gpitel/Lab/hardware/relay-board-revC/relay_board_BOM.md

# OpenMagnetics Relay Board rev C -- Bill of Materials
# GENERATED by generate_bom.py from relay_board.xml -- do not edit.

| Refs | Qty | Value | Part number | Notes |
|---|-----|---|---|---|
| C1,C23,C32,C33,C34,C35 | 6 | 10uF | - | C_0805_2012Metric |
| C18 | 1 | 1uF | - | C_0402_1005Metric |
| C19 | 1 | 10nF | - | C_0402_1005Metric |
| C2,C29 | 2 | 4.7uF | - | C_0805_2012Metric |
| C22 | 1 | 47uF | X5R 10 V 1206 | front-end output DC block |
| C3,C4,C20,C21 | 4 | 1uF | - | C_0603_1608Metric |
| C30 | 1 | 10pF C0G | - | C_0603_1608Metric |
| C31 | 1 | 4.7nF 100V | - | C_0603_1608Metric |
| C5-C37 | 17 | 100nF | - | C_0402_1005Metric |
| D1 | 1 | RUN | 0603 LED green | status: firmware running / USB host |
| D2 | 1 | USBLC6-2SC6 | ST USBLC6-2SC6 | USB 2.0 ESD array, IEC 61000-4-2 level 4 |
| D3,D4 | 2 | BAV99 | Nexperia BAV99,215 | front-end input clamp |
| D5 | 1 | PWR | 0603 LED green | status: power |
| D6 | 1 | BUSY | 0603 LED amber | status: relays switching |
| D7 | 1 | KELVIN | 0603 LED blue | status: Kelvin mode |
| D8 | 1 | PROG | 0603 LED red (KT-0603R) | status: DFU / firmware update |
| D9 | 1 | SMF5.0A | - | D_SOD-123F |
| FB1 | 1 | 220R@100MHz 2A | Murata BLM21PG221SN1D | VBUS ferrite, 2 A |
| FB2,FB3 | 2 | 600R@100MHz | Sunlord GZ1608D601TF | ferrite, 200 mA (VDDA, +5VA) |
| J1 | 1 | USB-C | HRO TYPE-C-31-M-12 | USB-C receptacle, USB 2.0, 16 pin |
| J10 | 1 | DUT A F | Grayhill 02-21 miniature test clip (banana plug) | Kelvin pair per terminal (F/S, 8 mm apart); plug straight into the plated 4.0 mm hole, hand-fitted (solder for a permanent fixture) |
| J11 | 1 | DUT A S | Grayhill 02-21 miniature test clip (banana plug) | Kelvin pair per terminal (F/S, 8 mm apart); plug straight into the plated 4.0 mm hole, hand-fitted (solder for a permanent fixture) |
| J12 | 1 | DUT B F | Grayhill 02-21 miniature test clip (banana plug) | Kelvin pair per terminal (F/S, 8 mm apart); plug straight into the plated 4.0 mm hole, hand-fitted (solder for a permanent fixture) |
| J13 | 1 | DUT B S | Grayhill 02-21 miniature test clip (banana plug) | Kelvin pair per terminal (F/S, 8 mm apart); plug straight into the plated 4.0 mm hole, hand-fitted (solder for a permanent fixture) |
| J14 | 1 | DUT C F | Grayhill 02-21 miniature test clip (banana plug) | Kelvin pair per terminal (F/S, 8 mm apart); plug straight into the plated 4.0 mm hole, hand-fitted (solder for a permanent fixture) |
| J15 | 1 | DUT C S | Grayhill 02-21 miniature test clip (banana plug) | Kelvin pair per terminal (F/S, 8 mm apart); plug straight into the plated 4.0 mm hole, hand-fitted (solder for a permanent fixture) |
| J16 | 1 | DUT D F | Grayhill 02-21 miniature test clip (banana plug) | Kelvin pair per terminal (F/S, 8 mm apart); plug straight into the plated 4.0 mm hole, hand-fitted (solder for a permanent fixture) |
| J17 | 1 | DUT D S | Grayhill 02-21 miniature test clip (banana plug) | Kelvin pair per terminal (F/S, 8 mm apart); plug straight into the plated 4.0 mm hole, hand-fitted (solder for a permanent fixture) |
| J6 | 1 | BNC SOURCE | Amphenol B6252HB-NPP3G-50 | 50R right-angle BNC jack |
| J7 | 1 | BNC CH1 | Amphenol B6252HB-NPP3G-50 | 50R right-angle BNC jack |
| J8 | 1 | SWD | CNC Tech 3220-10-0300-00 | 1.27 mm 2x5 Cortex debug header, SMD |
| J9 | 1 | BNC CH2 | Amphenol B6252HB-NPP3G-50 | 50R right-angle BNC jack |
| K1-K23 | 23 | G6K-2F-RF-S DC5 | Omron G6K-2F-RF-S DC5 | high-frequency DPDT relay, 5 V coil |
| L1 | 1 | 90R CM | TDK ACM2012-900-2P-T002 | USB CM choke, 90R @100 MHz; windings 1-4 / 2-3 |
| R1,R2 | 2 | 5.1k | - | R_0402_1005Metric |
| R10,R32,R33,R35,R38,R39 | 6 | 4.7k | - | R_0402_1005Metric |
| R12 | 1 | 1k 0.1% | Vishay TNPW08051K00BEEA | bridge RV1: 1k 0.1% 25 ppm thin film |
| R13,R16 | 2 | 47R 0.1% | Vishay TNPW080547R0BEEA | bridge RV2/RC2: 47R 0.1% 25 ppm thin film |
| R14,R15 | 2 | 4R7 | UNI-ROYAL TC0525B470KT5G (LCSC C21571495) | bridge RC1 shunt half: 4R7 0.1% 25 ppm thin film, JLC stock (two in parallel = 2R35); equivalent: Vishay TNPW08054R70BEEA |
| R17,R34 | 2 | 1k | - | R_0402_1005Metric |
| R18 | 1 | 1R 0.5% | - | R_1206_3216Metric |
| R20,R22,R29,R40 | 4 | 100k | - | R_0402_1005Metric |
| R21,R23 | 2 | 100R | - | R_0402_1005Metric |
| R24,R25,R26,R27 | 4 | 1k 0.1% | Yageo RT0603BRD071KL | front-end difference stage, 0.1 % 25 ppm |
| R28 | 1 | 49.9R | - | R_0402_1005Metric |
| R3,R4,R31,R41 | 4 | 10k | - | R_0402_1005Metric |
| R30 | 1 | 18k | - | R_0402_1005Metric |
| R36 | 1 | 1M | - | R_0603_1608Metric |
| R37 | 1 | 0R | - | R_0603_1608Metric |
| R5 | 1 | 100R 0.1% | Vishay TNPW0805100RBEEA | LOAD standard: 100R 0.1% 25 ppm thin film |
| SW1 | 1 | BOOT | C&K TL3342F160QG (or XKB TS-1187A-B-A-B) | SMD tact switch: hold at power-up for ROM DFU |
| SW2 | 1 | RESET | C&K TL3342F160QG (or XKB TS-1187A-B-A-B) | SMD tact switch: NRST |
| U1 | 1 | STM32F072CBT6 | ST STM32F072CBT6 | Cortex-M0, 128K flash, crystal-less USB (HSI48 + CRS) |
| U11 | 1 | TPS2051CDBV | - | SOT-23-5 |
| U12 | 1 | TMP117AIDRV | - | WSON-6-1EP_2x2mm_P0.65mm_EP1x1.6mm |
| U2,U3,U4,U6 | 4 | TBD62003APG | Toshiba TBD62003AFG | 7ch DMOS sink driver (SOIC-16 = AFG suffix) |
| U5 | 1 | AP2112K-3.3 | Diodes AP2112K-3.3TRG1 | 3.3 V 600 mA LDO, 250 mV dropout |
| U7,U8,U9,U10 | 4 | OPA356 | TI OPA356AIDBVR | 200 MHz RRO op-amp, single 2.5-5.5 V (Kelvin front-end) |

Total placements: 132

Hardware (not in the netlist):

| Item | Qty | Part | Notes |
|---|-----|---|---|
| Standoff M3 x 25 mm, F-F | 5 | Wurth 970250321 (WA-SSTII, steel; or any M3 hex standoff >= 25 mm) | legs under H1-H5: the 02-21 banana plugs stand ~22 mm below the board |
| Screw M3 x 6 mm | 5 | any | board to standoffs |

Notes:
- All components on the top side; single-sided assembly.
- R5 is the calibration LOAD standard: substitutions must hold 0.1%
  and low TCR or every calibrated measurement inherits the error.
- Relays: G6K-2F-RF-S DC5 (5 V coil suits the USB-derived +5 V rail
  through the TBD62003's ~0.15 V drop). ~26 week lead time -- order first.
- USB VID/PID are pid.codes test values; register before distributing.
