gpitel/Lab/hardware/relay-board-revC/relay_board_JLC_BOM.xlsx

Comment | Designator | Footprint | JLCPCB Part #（optional）
CL21A106KAYNNNE | C1,C23,C32,C33,C34,C35 | C0805 | C15850
CL05A105KA5NQNC | C18 | C0402 | C52923
CL05B103KB5NNNC | C19 | C0402 | C15195
CL21A475KAQNNNE | C2,C29 | C0805 | C1779
CL31A476MPHNNNE | C22 | C1206 | C96123
CL10A105KB8NNNC | C3,C4,C20,C21 | C0603 | C15849
GRM1885C1H100GA01D | C30 | C0603 | C2987939
CL05B104KO5NNNC | C5,C6,C7,C8,C9,C10,C11,C12,C15,C16,C17,C25,C26,C27,C28,C36,C37 | C0402 | C1525
XL-1608SYGC-06 | D1 | LED0603 | C965805
USBLC6-2SC6 | D2 | SOT-23-6 | C2827654
BAV99,215 | D3,D4 | SOT-23 | C2500
XL-1608SYGC-06 | D5 | LED0603 | C965805
XL-1608UYC-06 | D6 | LED0603 | C965802
XL-1608UBC-04 | D7 | LED0603 | C965807
KT-0603R | D8 | LED0603 | C2286
SMF5.0A | D9 | D_SOD-123F | C151296
BLM21PG221SN1D | FB1 | L0805 | C85840
GZ1608D601TF | FB2,FB3 | L0603 | C1002
TYPE-C-31-M-12 | J1 | USB_C_Receptacle_HRO_TYPE-C-31-M-12 | C165948
HX PZ1.27-2x5P TP | J8 | PinHeader_2x05_P1.27mm_Vertical_SMD | C41376037
G6K-2F-Y-TR DC5 | K1,K2,K3,K4,K5,K6,K7,K8,K9,K10,K11,K12,K13,K14,K15,K16,K17,K18,K19,K20,K21,K22,K23 | Relay_Omron_G6K-2F-RF-S | C47190
ACM2012-900-2P-T001 | L1 | L_CommonModeChoke_Coilank_ACM2012 | C307642
0402WGF5101TCE | R1,R2 | R0402 | C25905
0402WGF4701TCE | R10,R32,R33,R35,R38,R39 | R0402 | C25900
TNPW08051K00BEEA | R12 | R0805 | C2073519
RT0805BRD0747RL | R13,R16 | R0805 | C136921
TC0525B470KT5G | R14,R15 | R0805 | C21571495
0402WGF1001TCE | R17,R34 | R0402 | C11702
RT1206DRD071RL | R18 | R1206 | C111291
0402WGF1003TCE | R20,R22,R29,R40 | R0402 | C25741
0402WGF1000TCE | R21,R23 | R0402 | C25076
RT0603BRD071KL | R24,R25,R26,R27 | R0603 | C110776
0402WGF499JTCE | R28 | R0402 | C25120
0402WGF1002TCE | R3,R4,R31,R41 | R0402 | C25744
0402WGF1802TCE | R30 | R0402 | C25762
0603WAF0000T5E | R37 | R0603 | C21189
TNPW0805100RBEEA | R5 | R0805 | C2073390
TS-1187A-B-A-B | SW1 | SW_SPST_TL3342 | C318884
TS-1187A-B-A-B | SW2 | SW_SPST_TL3342 | C318884
STM32F072CBT6 | U1 | LQFP-48 | C81720
TPS2051CDBVR | U11 | SOT-23-5 | C129581
TMP117AIDRVR | U12 | WSON-6-1EP_2x2mm_P0.65mm_EP1x1.6mm | C699536
TBD62003AFG(Z,EL) | U2,U3,U4,U6 | SOIC-16 | C163227
AP2112K-3.3TRG1 | U5 | SOT-23-5 | C23380830
OPA356AIDBVR | U7,U8,U9,U10 | SOT-23-5 | C183100
