gpitel/Lab/(list of files, drawings)

Other design files:
hardware/relay-board-revC/relay_board.dsn
