gpitel/Lab/hardware/relay-board-revC/relay_board.kicad_pcb

## KiCad design hardware/relay-board-revC/relay_board.kicad_pcb (2026-10-26)

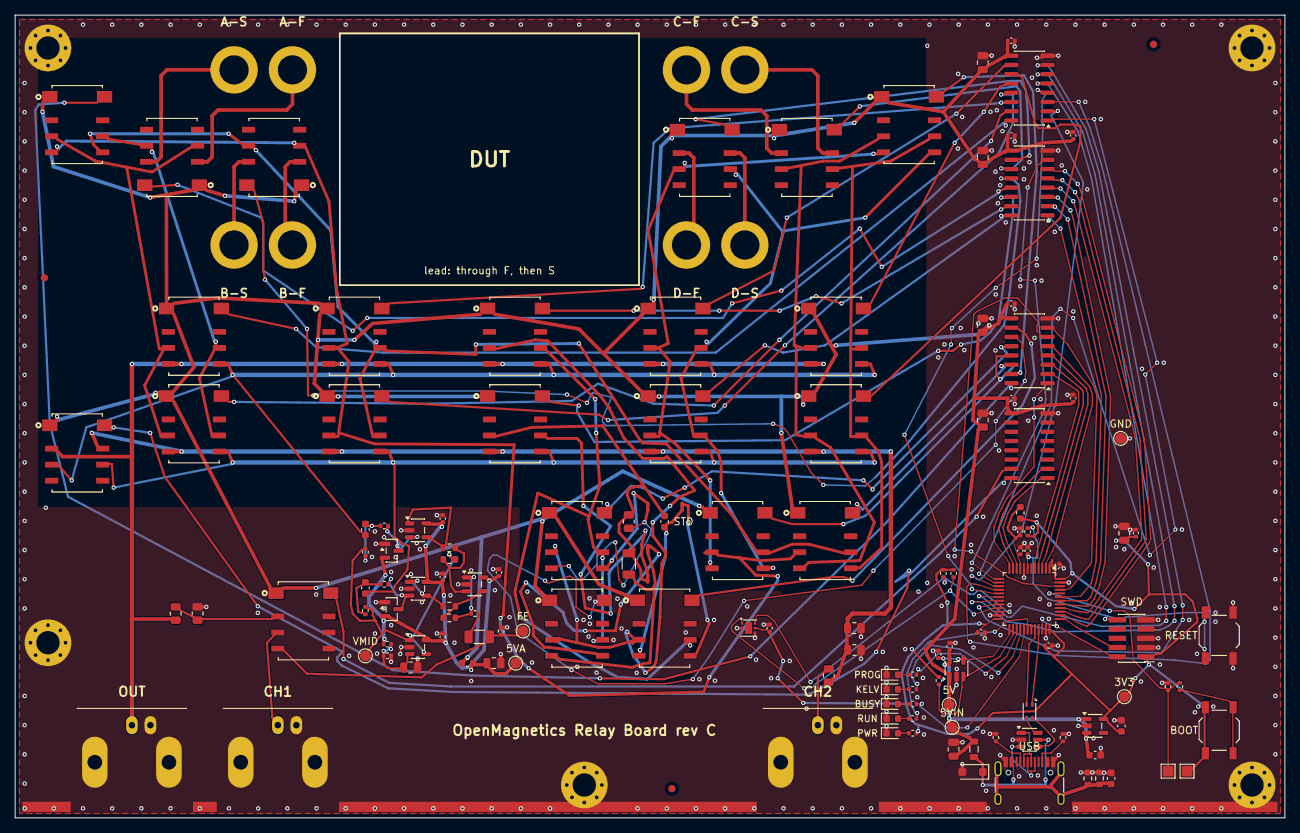
[picture p1: board relay_board.kicad_pcb from above]

Board: 4 copper layers, 174.0 x 110.0 mm, 158 parts (0 on the bottom side), 126 nets.

Parts:
BOND1, BOND2, BOND3, BOND4, BOND5: GND bonding strip; GND_BondingStrip
C1, C2, C23, C29, C32, C33, C34, C35: C_0805_2012Metric
C3, C4, C20, C21, C30, C31: C_0603_1608Metric
C5, C6, C7, C8, C9, C10, C11, C12, C15, C16, C17, C18, C19, C25, C26, C27, C28, C36, C37: C_0402_1005Metric
C22: C_1206_3216Metric
D1, D5, D6, D7, D8: LED_0603_1608Metric
D2: SOT-23-6
D3, D4: SOT-23
D9: D_SOD-123F
FB1: L_0805_2012Metric
FB2, FB3: L_0603_1608Metric
FID1, FID2, FID3: Fiducial_1mm_Mask2mm
H1, H2, H3, H4, H5: MountingHole_3.2mm_M3_Pad_Via
J1: USB_C_Receptacle_HRO_TYPE-C-31-M-12
J6, J7, J9: BNC_Amphenol_B6252HB-NPP3G-50_Horizontal
J8: PinHeader_2x05_P1.27mm_Vertical_SMD
J10, J11, J12, J13, J14, J15, J16, J17: Grayhill 02-21; Grayhill_02-21_BananaPlug_4mm
K1, K2, K3, K4, K5, K6, K7, K8, K9, K10, K11, K12, K13, K14, K15, K16, K17, K18, K19, K20, K21, K22, K23: G6K-2F-RF-S; Relay_Omron_G6K-2F-RF-S
L1: L_CommonModeChoke_Coilank_ACM2012
NT1, NT2, NT4, NT5: NetTie-2_SMD_Pad0.5mm
R1, R2, R3, R4, R10, R17, R20, R21, R22, R23, R28, R29, R30, R31, R32, R33, R34, R35, R38, R39, R40, R41: R_0402_1005Metric
R5, R12, R13, R14, R15, R16: R_0805_2012Metric
R18: R_1206_3216Metric
R24, R25, R26, R27, R36, R37: R_0603_1608Metric
SW1, SW2: SW_SPST_TL3342
TP1, TP2: TestPoint_Pad_1.5x1.5mm
TP3, TP4, TP5, TP6, TP7, TP8, TP9: TestPoint_Pad_D1.5mm
U1: LQFP-48_7x7mm_P0.5mm
U2, U3, U4, U6: SOIC-16_3.9x9.9mm_P1.27mm
U5, U7, U8, U9, U10, U11: SOT-23-5
U12: WSON-6-1EP_2x2mm_P0.65mm_EP1x1.6mm

Connections:
/+3V3: C2.1, C4.1, C8.1, C9.1, C16.1, C17.1, C36.1, FB3.1, J8.1, R3.1, R32.1, R38.2, R39.2, R41.2, SW1.1, TP2.1, TP5.1, U1.1, U1.24, U1.36, U1.48, U5.5, U12.5
/+3V3A: C18.1, C19.1, FB3.2, U1.9
/+5V: C5.1, C6.1, C7.1, C10.1, C11.1, C12.1, C32.1, C33.1, C34.1, C35.1, FB2.1, K1.1, K2.1, K3.1, K4.1, K5.1, K6.1, K7.1, K8.1, K9.1, K10.1, K11.1, K12.1, K13.1, K14.1, K15.1, K16.1, K17.1, K18.1, K19.1, K20.1, K21.1, K22.1, K23.1, TP3.1, U2.9, U3.9, U4.9, U6.9, U11.1
/+5VA: C25.1, C26.1, C27.1, C28.1, C29.1, D3.2, D4.2, FB2.2, R30.1, TP6.1, U7.5, U8.5, U9.5, U10.5
/+5V_IN: C1.1, C3.1, C37.1, FB1.2, TP4.1, U5.1, U5.3, U11.5
/BOOT0: R4.1, R17.2, TP1.1, U1.44
/BOOT_SW: R17.1, SW1.2
/BUSY_A: D6.2, R33.2
/CAL_E: K9.3, K19.3, K20.3, K21.3
/CAL_ES: K9.6, K19.6, K20.6, K21.6
/CAL_F: C30.2, K10.3, NT2.1, R5.2, R18.2
/CAL_FS: K10.6, NT2.2
/CC1: J1.A5, R1.1
/CC2: J1.B5, R2.1
/CH1_BNC: J7.1, K23.3
/CH1_NODE: K23.2, R12.2, R13.1
/CH2_NODE: J9.1, R16.2
/COIL_EN: R40.1, U1.25, U11.4
/COIL_FLT: R41.1, U1.26, U11.3
/DUTS_A: J11.1, K11.7
/DUTS_B: J13.1, K12.7
/DUTS_C: J15.1, K13.7
/DUTS_D: J17.1, K14.7
/DUT_A: J10.1, K11.2
/DUT_B: J12.1, K12.2
/DUT_C: J14.1, K13.2
/DUT_D: J16.1, K14.2
/FE_AMP: R25.2, R28.1, U9.1
/FE_BN: R24.1, U8.1, U8.4
/FE_BP: R26.1, U7.1, U7.4
/FE_DM: R24.2, R25.1, U9.4
/FE_DP: R26.2, R27.1, U9.3
/FE_INN: C21.2, R22.1, R23.1
/FE_INP: C20.2, R20.1, R21.1
/FE_N: D4.3, R23.2, U8.3
/FE_OUT: C22.2, K23.4, R29.1, TP8.1
/FE_P: D3.3, R21.2, U7.3
/FE_R: C22.1, R28.2
/GND: BOND1.1, BOND2.1, BOND3.1, BOND4.1, BOND5.1, C1.2, C2.2, C3.2, C4.2, C5.2, C6.2, C7.2, C8.2, C9.2, C10.2, C11.2, C12.2, C15.2, C16.2, C17.2, C18.2, C19.2, C23.2, C25.2, C26.2, C27.2, C28.2, C29.2, C31.2, C32.2, C33.2, C34.2, C35.2, C36.2, C37.2, D1.1, D2.2, D3.1, D4.1, D5.1, D6.1, D7.1, D8.1, D9.2, H1.1, H2.1, H3.1, H4.1, H5.1, J1.A1, J1.A12, J1.B1, J1.B12, J6.2, J7.2, J8.3, J8.5, J8.9, J9.2, R1.2, R2.2, R4.2, R13.2, R14.2, R15.2, R29.2, R31.2, R36.2, R37.2, R40.2, SW2.2, TP9.1, U1.8, U1.23, U1.35, U1.47, U2.8, U3.8, U4.8, U5.2, U6.8, U7.2, U8.2, U9.2, U10.2, U11.2, U12.2, U12.4
/GPIO1: U1.14, U2.1
/GPIO2: U1.15, U2.2
/GPIO3: U1.16, U2.3
/GPIO4: U1.17, U2.4
/GPIO5: U1.18, U2.5
/GPIO6: U1.19, U2.6
/GPIO7: U1.20, U2.7
/GPIO8: U1.43, U3.1
/GPIO9: U1.42, U3.2
/GPIO10: U1.41, U3.3
/GPIO11: U1.40, U3.4
/GPIO12: U1.39, U3.5
/GPIO13: U1.38, U3.6
/GPIO14: U1.13, U3.7
/GPIO15: U1.12, U4.1
/GPIO16: U1.5, U4.2
/GPIO17: U1.4, U4.3
/GPIO18: U1.3, U4.4
/GPIO19: U1.2, U4.5
/GPIO20: U1.46, U4.6
/GPIO21: U1.45, U4.7
/GPIO22: U1.10, U6.1
/GPIO23: U1.11, U6.2
/I2C_SCL: R38.1, U1.21, U12.1
/I2C_SDA: R39.1, U1.22, U12.6
/K1_COIL: K1.8, U2.16
/K2_COIL: K2.8, U2.15
/K3_COIL: K3.8, U2.14
/K4_COIL: K4.8, U2.13
/K5_COIL: K5.8, U2.12
/K6_COIL: K6.8, U2.11
/K7_COIL: K7.8, U2.10
/K8_COIL: K8.8, U3.16
/K9_COIL: K9.8, U3.15
/K10_COIL: K10.8, U3.14
/K11_COIL: K11.8, U3.13
/K12_COIL: K12.8, U3.12
/K13_COIL: K13.8, U3.11
/K14_COIL: K14.8, U3.10
/K15_COIL: K15.8, U4.16
/K16_COIL: K16.8, U4.15
/K17_COIL: K17.8, U4.14
/K18_COIL: K18.8, U4.13
/K19_COIL: K19.8, U4.12
/K20_COIL: K20.8, U4.11
/K21_COIL: K21.8, U4.10
/K22_COIL: K22.8, U6.16
/K23_COIL: K23.8, U6.15
/KELVIN_A: D7.2, R34.2
/LED_BUSY: R33.1, U1.29
/LED_KELVIN: R34.1, U1.28
/LED_PROG: R35.1, U1.27
/LED_RUN: R10.1, U1.30
/NRST: C15.1, J8.10, R3.2, SW2.1, U1.7
/PROG_A: D8.2, R35.2
/PWR_A: D5.2, R32.2
/RAIL_HI: J6.1, K1.4, K3.4, K5.4, K7.4, K9.4, K22.2, R12.1
/RAIL_LO: K2.4, K4.4, K6.4, K8.4, K10.4, K22.7, R14.1, R15.1, R16.1
/RUN_A: D1.2, R10.2
/SA: K1.6, K2.6, K11.6, K15.6
/SB: K3.6, K4.6, K12.6, K15.5, K17.6, K18.6
/SC: K5.6, K6.6, K13.6, K16.6, K17.5
/SD: K7.6, K8.6, K14.6, K16.5, K18.5
/SNS_HI: C20.1, K1.5, K3.5, K5.5, K7.5, K9.5, K22.3
/SNS_LO: C21.1, K2.5, K4.5, K6.5, K8.5, K10.5, K22.6
/STD1_F: K19.4, NT1.1, R5.1
/STD1_S: K19.5, NT1.2
/STD2_F: K20.4, NT4.1, R18.1
/STD2_S: K20.5, NT4.2
/STD3_F: C30.1, K21.4, NT5.1
/STD3_S: K21.5, NT5.2
/SWCLK: J8.4, U1.37
/SWDIO: J8.2, U1.34
/TA: K1.3, K2.3, K11.3, K15.3
/TB: K3.3, K4.3, K12.3, K15.4, K17.3, K18.3
/TC: K5.3, K6.3, K13.3, K16.3, K17.4
/TD: K7.3, K8.3, K14.3, K16.4, K18.4
/USB_DM: L1.2, U1.32
/USB_DM_CON: D2.1, J1.A7, J1.B7
/USB_DM_ESD: D2.6, L1.3
/USB_DP: L1.1, U1.33
/USB_DP_CON: D2.3, J1.A6, J1.B6
/USB_DP_ESD: D2.4, L1.4
/USB_SHIELD: C31.1, J1.SH, R36.1, R37.1
/VBUS: D2.5, D9.1, FB1.1, J1.A4, J1.A9, J1.B4, J1.B9
/VMID: R20.2, R22.2, R27.2, TP7.1, U10.1, U10.4
/VMID_DIV: C23.1, R30.2, R31.1, U10.3
