gpitel/Lab/(commit log)

2026-10-26 Rev C as built: design, fab and JLC files of the manufactured boards
    Schematic, routed PCB, netlist, generator/router scripts and docs as sent
    to JLCPCB (fab outputs of 2026-10-13), Grayhill 02-21 clip footprint, the
    via-out-of-pad fixes, the driven-guard study, BOM, JLC BOM/CPL, the fab
    bundle and the review zip for N. Rosano. relay_map_revc.h is the map
    generated from this schematic, checked against the netlist and flashed on
    both built boards (firmware 2.0.0).
    [relay_board-B_Cu.gbl, relay_board-B_Mask.gbs, relay_board-B_Paste.gbp, relay_board-B_Silkscreen.gbo, relay_board-Edge_Cuts.gm1, relay_board-F_Cu.gtl, relay_board-F_Mask.gts, relay_board-F_Paste.gtp]
2026-10-26 Rev C bring-up: driver uses the 23-relay map
    RelayBoardController assumed 24 relays on rev C and raised IndexError on
    the firmware's 23-entry RELAY:ALL? readback (Kelvin configs, any full-word
    drive). Take the count from RelayMapRevC.RELAY_COUNT; the firmware map
    comment follows RELAY_COUNT too. Both built boards pass the relay readback
    of all 19 configs x 4 modes in 2-wire and Kelvin mode, TMP117, UID, coil
    switch, wear counters and the SYST:DFU update.
